mariusl/diyBMSv4/ModuleV450/export/ModuleV450-top.png

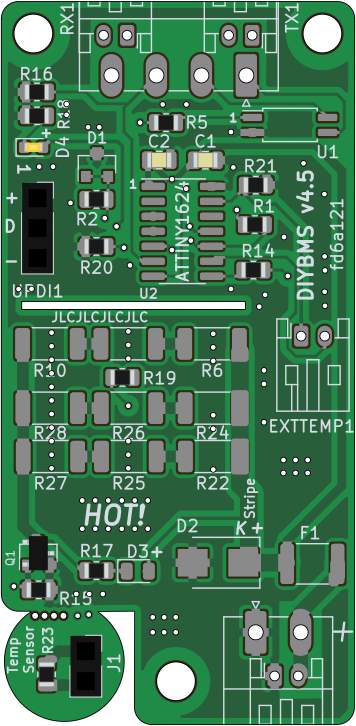
ModuleV450/export/ModuleV450-top.png
