mariusl/diyBMSv4/ModuleV450/export/Schematic.pdf

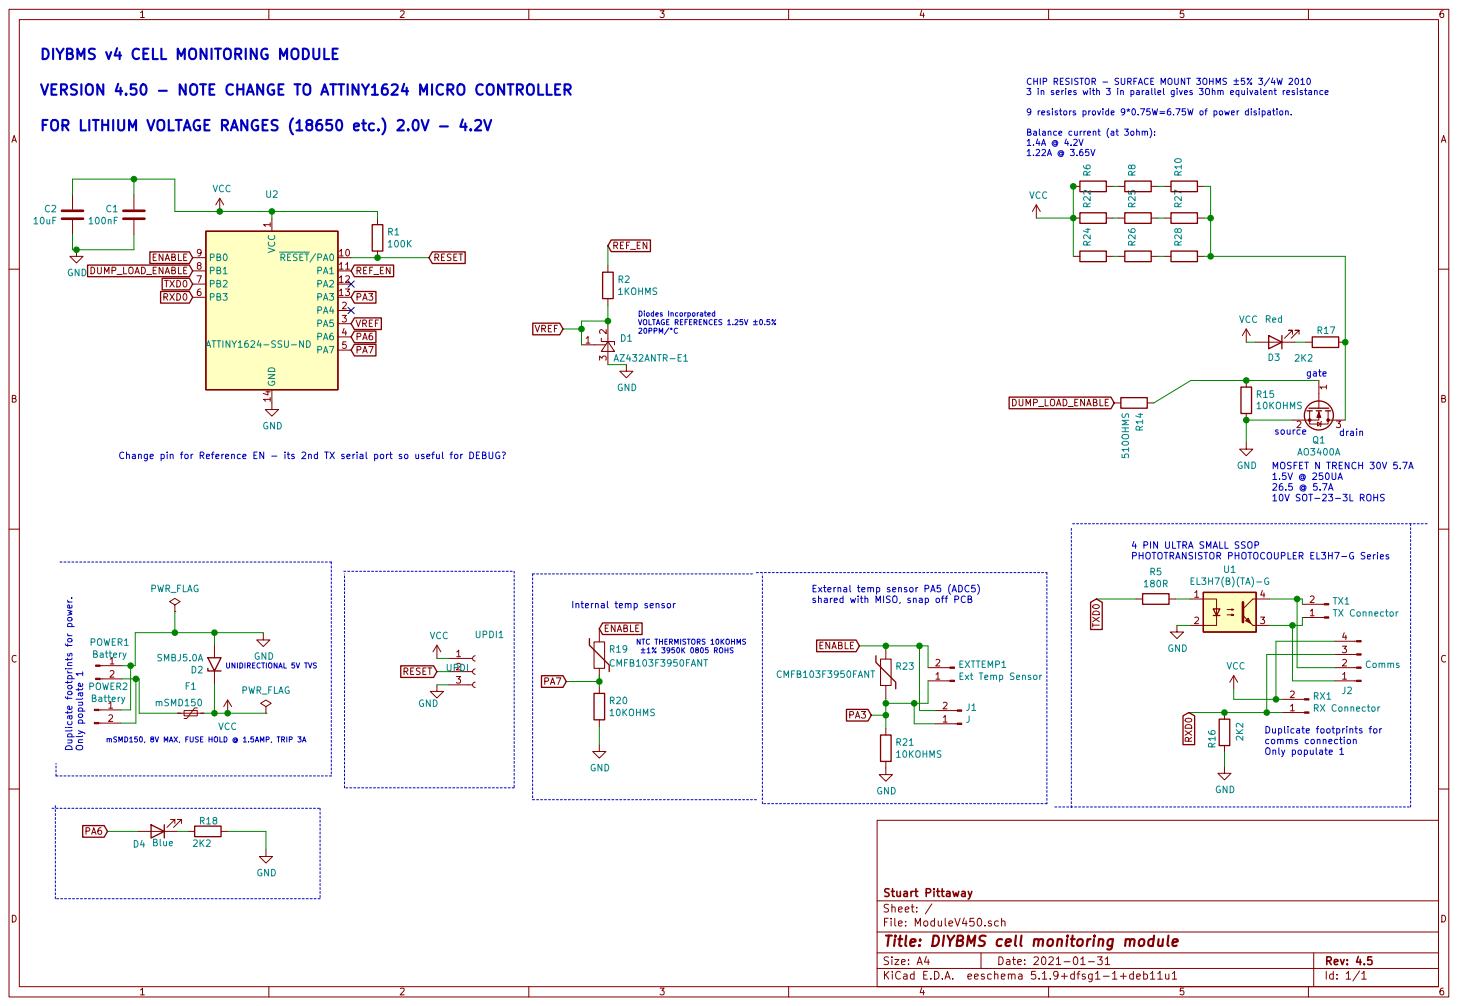
[picture p2: page 1]

DIYBMS v4 CELL MONITORING MODULE

source CHIP RESISTOR - SURFACE MOUNT 3OHMS ±5% 3/4W 2010
3 in series with 3 in parallel gives 3Ohm equivalent resistance

VERSION 4.50 - NOTE CHANGE TO ATTINY1624 MICRO CONTROLLER

9 resistors provide 9*0.75W=6.75W of power disipation. Balance current (at 3ohm): 1.4A @ 4.2V

FOR LITHIUM VOLTAGE RANGES (18650 etc.) 2.0V - 4.2V

1.22A @ 3.65V mSMD150, 8V MAX, FUSE HOLD @ 1.5AMP, TRIP 3A Duplicate footprints for power. Only populate 1

1 RESET/PA0 10 PA1 11 PA2 12 PA3 13 GND 14 PA4 2 PA5 3 PA6 4 PA7 5 PB3 6 PB2 7 PB1 8 PB0 9 U2 ATTINY1624-SSU-ND

PHOTOTRANSISTOR PHOTOCOUPLER EL3H7-G Series Change pin for Reference EN - its 2nd TX serial port so useful for DEBUG?

4 PIN ULTRA SMALL SSOP

shared with MISO, snap off PCB

Duplicate footprints for comms connection Only populate 1

File: ModuleV450.sch Sheet: / Stuart Pittaway

Id: 1/1 Title: DIYBMS cell monitoring module
